TheLlamainator/TI84-AI-Mod/docs/index.md

---
layout: home
title: TI-84 AI Mod, WiFi and GPT for a calculator
titleTemplate: false
hero:
  text: "Give a <span class='ti'>TI-84</span> calculator WiFi"
  tagline: GPT chat, a camera view, a self-hosted server and wireless firmware updates, using an ESP32-S3.
  actions:
    - theme: brand
      text: Read the overview
      link: /overview
    - theme: alt
      text: Build it
      link: /ordering-the-pcb
    - theme: alt
      text: View on GitHub
      link: https://github.com/TheLlamainator/TI84-AI-Mod
features:
  - title: Ask GPT
    details: Type a question on the calculator, read the answer a page at a time, and reply to carry on the conversation.
  - title: Camera
    details: With a XIAO ESP32S3 Sense, take pictures and see a slow black-and-white live view on the calculator screen.
  - title: Wireless updates
    details: Update the calculator program and the ESP32 firmware over WiFi from the calculator's SETTINGS menu. No USB cable after the first flash.
  - title: Your own server
    details: A small Node.js server does the internet work. You run it, you hold the keys.
---
