TheLlamainator/TI84-AI-Mod/docs/credits.md

---
title: Credits and licence
---

# Credits and licence

This is a modification of the original **TI-32** project, released under the **GNU General Public License v3**. The original author has since taken the project down. The GPL grants everyone who received the code the right to keep, modify and share it, provided the licence and notices are kept. See [LICENSE](https://github.com/TheLlamainator/TI84-AI-Mod/blob/main/LICENSE) and [NOTICE.md](https://github.com/TheLlamainator/TI84-AI-Mod/blob/main/NOTICE.md) for what came from the original and what was changed here.

The calculator link code uses **ArTICL** by Kerm Martian (Cemetech), installed separately from its own repository.

This repository is licensed under the GPL v3 as well.

The calculator disassembly steps on the [Wiring and parts](/wiring) page are adapted from [TI-84 Plus Disassembly](https://www.ifixit.com/Guide/TI-84+Plus+Disassembly/117983) on iFixit by martijn muntenaar and 6 other contributors, licensed under [Creative Commons BY-NC-SA](https://creativecommons.org/licenses/by-nc-sa/3.0/). That section keeps that licence.
