TheLlamainator/TI84-AI-Mod/pcb/jlcpcb/BOM.csv

Comment | Designator | Footprint | LCSC Part #
MMBF170 | Q1,Q2 | SOT-23 | C130879
