TheLlamainator/TI84-AI-Mod/docs/wiring.md

# Wiring and hardware

> **TODO (author):** the wiring part of this page (below the disassembly) is still yours to write.

## 1. Open the calculator

::: info Source and licence
This section is adapted from **[TI-84 Plus Disassembly](https://www.ifixit.com/Guide/TI-84+Plus+Disassembly/117983)** on iFixit, by martijn muntenaar and 6 other contributors, licensed under [Creative Commons BY-NC-SA](https://creativecommons.org/licenses/by-nc-sa/3.0/). Changes: the text is lightly shortened, the photos are converted to PNG, and step 8 is added (it is not from iFixit). The licence on this section is **BY-NC-SA**, not the GPL used for the code. iFixit does not endorse this project.
:::

**Time:** about 10 minutes. **Difficulty:** moderate.

### What you need

- TR6 Torx security screwdriver
- Phillips #0 screwdriver
- Spudger
- Opening picks (a set of 6 works well)

### Step 1: Flip it over

Be sure the calculator is powered off before you start.

Take off the sliding cover, and flip your calculator to the back side.

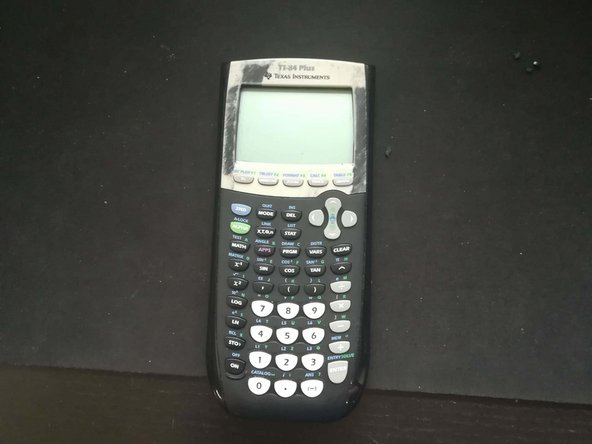
[picture p2: docs/public/img/disassembly/step-1-0.png]
Step 1: slide the cover off

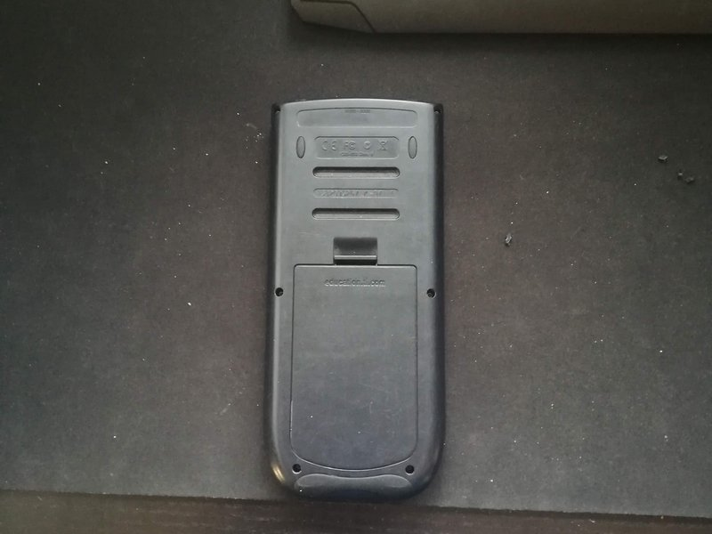
[picture p3: docs/public/img/disassembly/step-1-1.png]
Step 1: flip the calculator to the back


### Step 2: Remove the battery cover

Press down on the latch, then remove the battery cover.

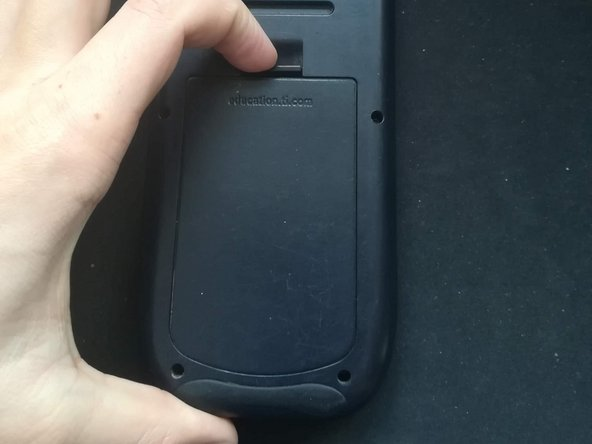
[picture p4: docs/public/img/disassembly/step-2-0.png]
Step 2: press the latch

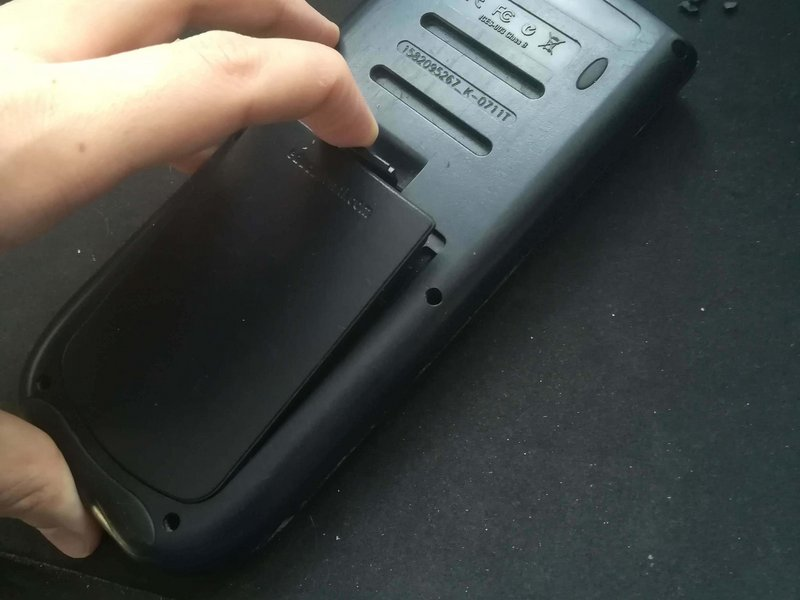
[picture p5: docs/public/img/disassembly/step-2-1.png]
Step 2: battery cover off


### Step 3: Take out the batteries

Remove the batteries. You can use the battery cover as a tray to keep them in.

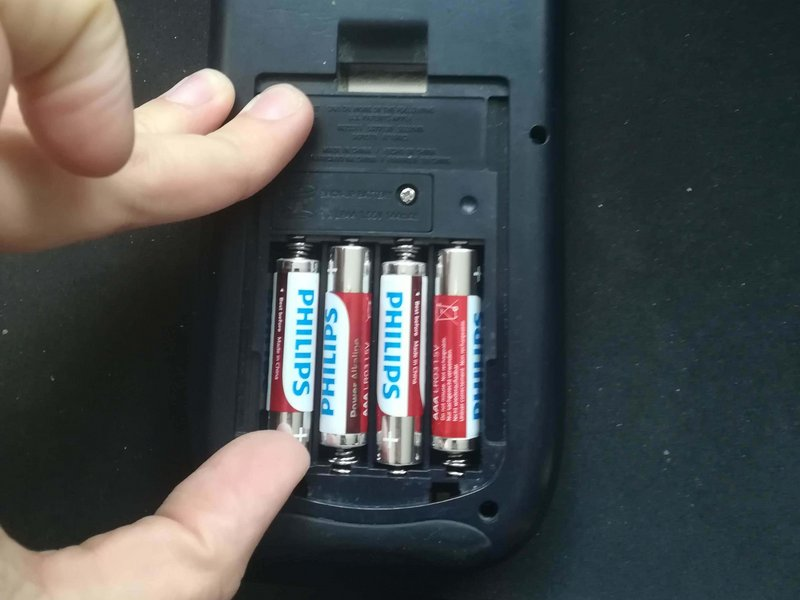
[picture p6: docs/public/img/disassembly/step-3-0.png]
Step 3: remove the batteries

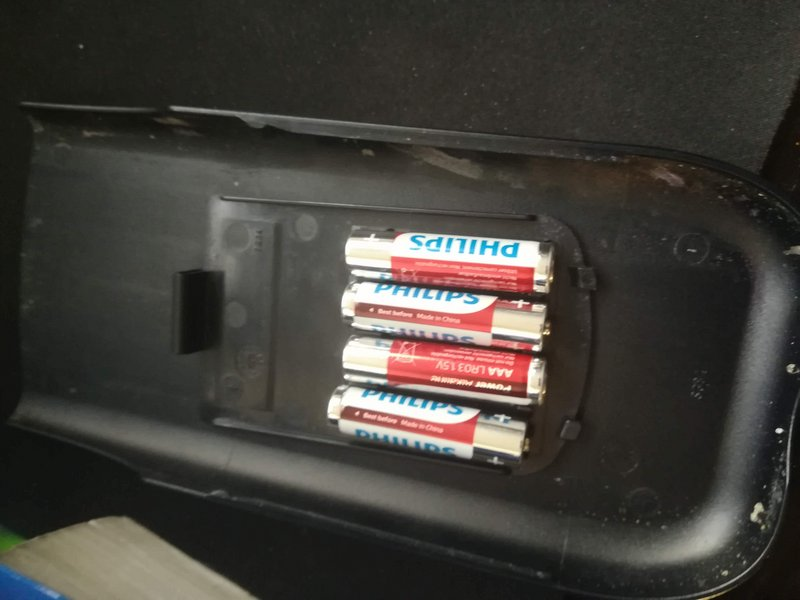
[picture p7: docs/public/img/disassembly/step-3-1.png]
Step 3: batteries out


### Step 4: Back-up battery plate

Removing the back-up battery will clear your RAM, so make a backup of anything important first.

Use a Phillips #0 to remove the plate over the back-up battery.

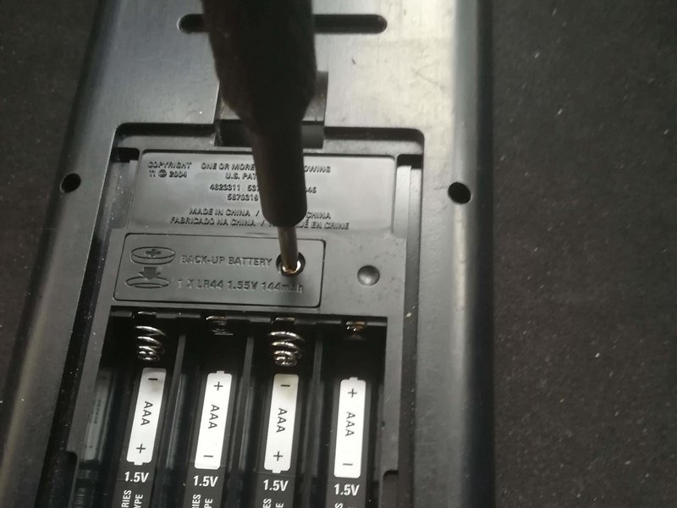
[picture p8: docs/public/img/disassembly/step-4-0.png]
Step 4: back-up battery plate

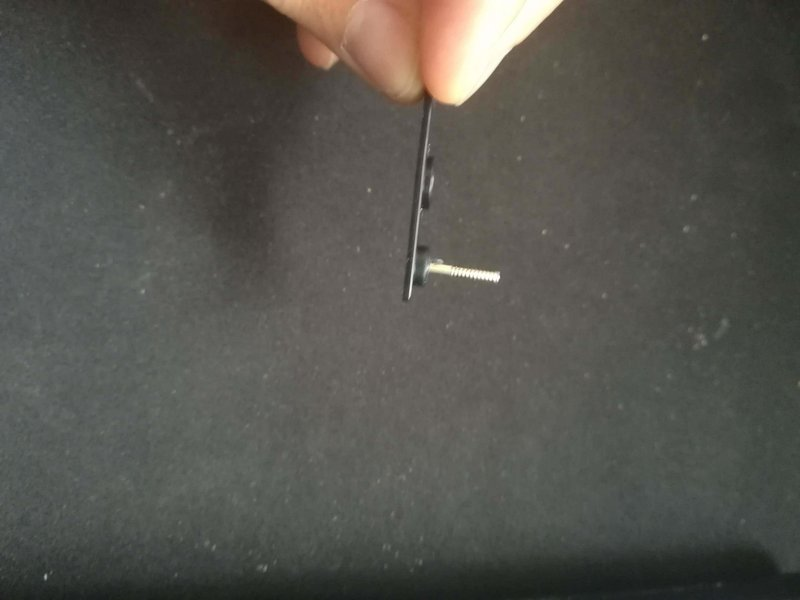
[picture p9: docs/public/img/disassembly/step-4-1.png]
Step 4: unscrew the plate

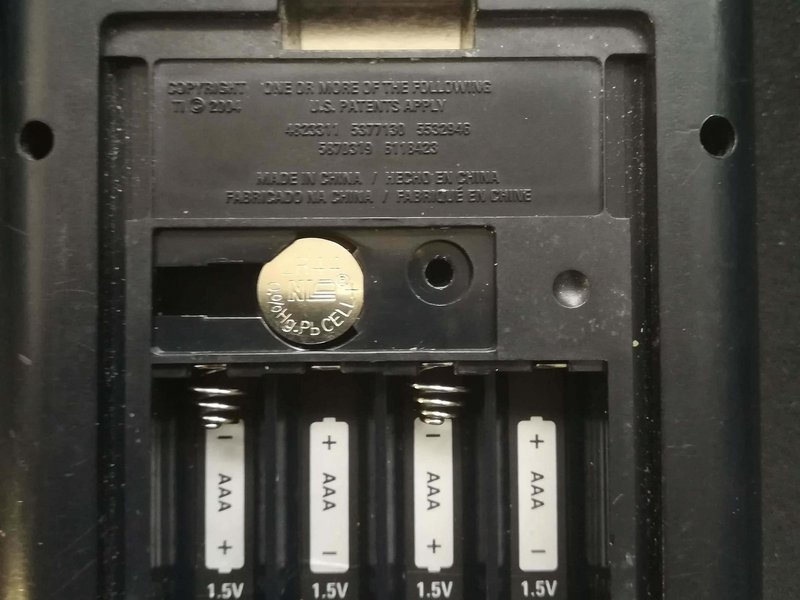
[picture p10: docs/public/img/disassembly/step-4-2.png]
Step 4: plate removed


### Step 5: Remove the back-up battery

Take out the back-up battery with a screwdriver or the spudger.

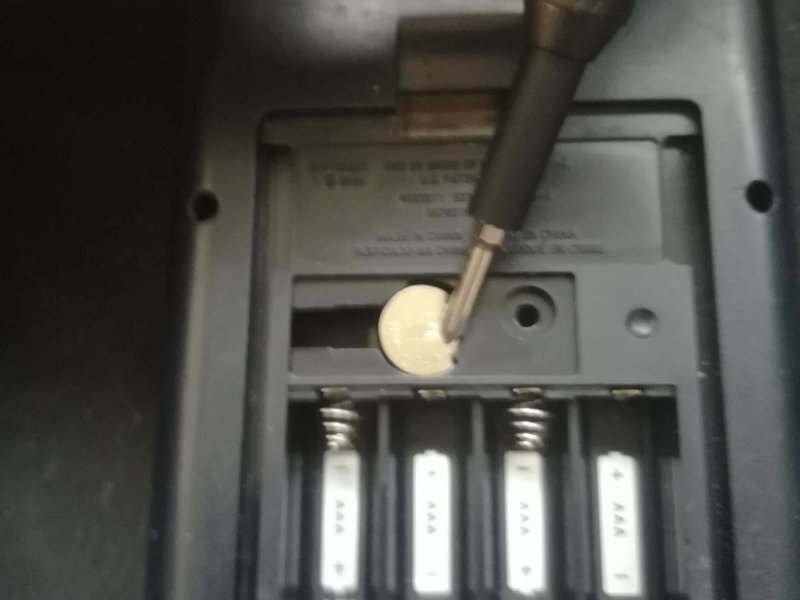
[picture p11: docs/public/img/disassembly/step-5-0.png]
Step 5: back-up battery in place

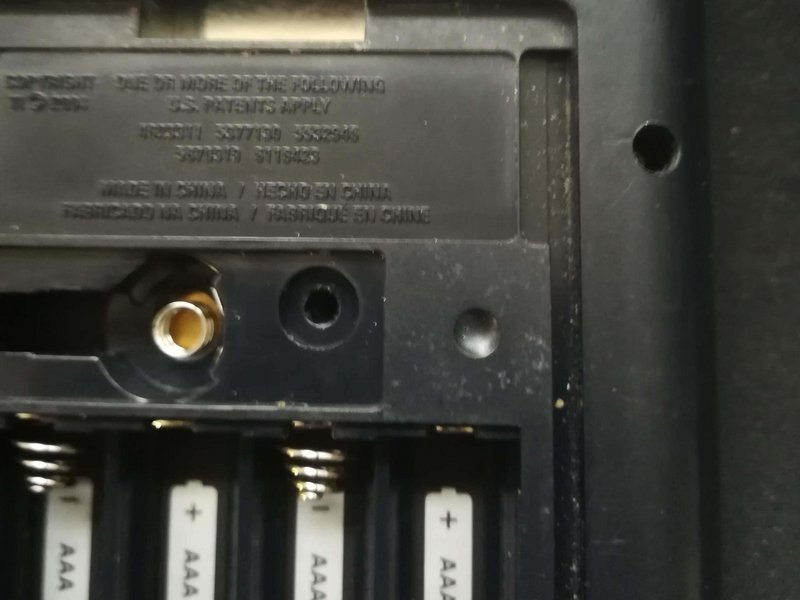
[picture p12: docs/public/img/disassembly/step-5-1.png]
Step 5: back-up battery removed


### Step 6: Remove the back cover screws

Use a T6 Torx screwdriver to remove the six screws holding the back cover on.

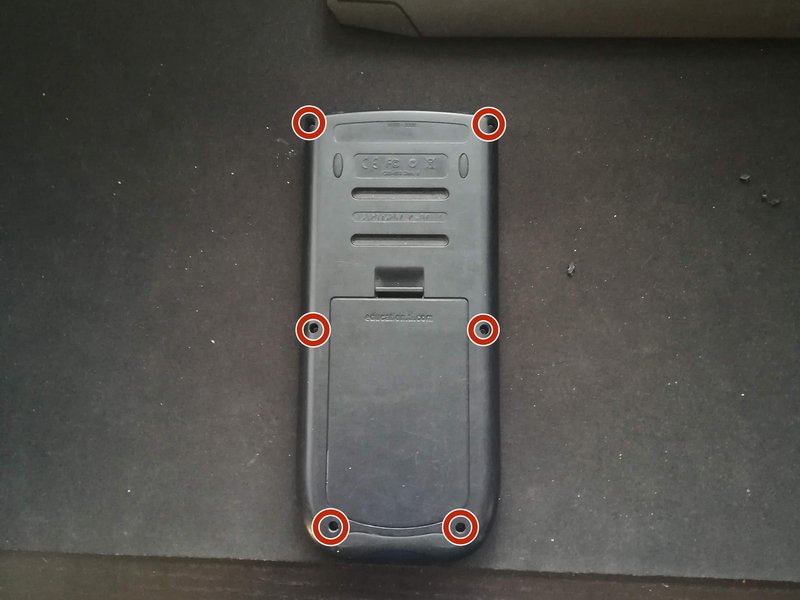
[picture p13: docs/public/img/disassembly/step-6.png]
Step 6: six Torx screws


::: tip Can't reach a screw?
If you can't get a screwdriver on one of the screws, what the author did was **melt the plastic around it with a soldering iron** until the screw came free. This leaves the case a little damaged, so only do it if you have to. Work in a ventilated room, keep the iron away from the circuit board inside, and let the plastic cool before you touch it.
:::

*This tip is from the author. It is not part of the iFixit guide.*

### Step 7: Open the case

Work a pick into the seam at the side, then slide it down the edge until the case opens.

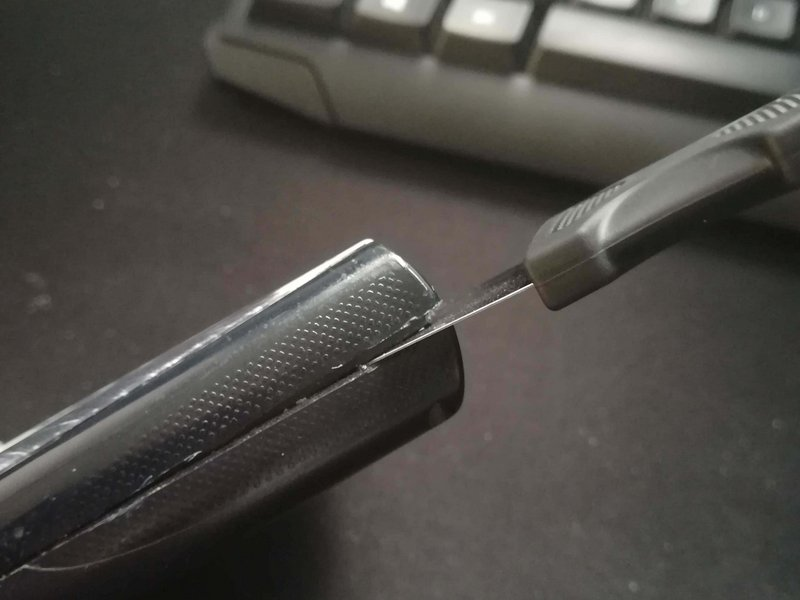
[picture p14: docs/public/img/disassembly/step-7-0.png]
Step 7: pick in the seam

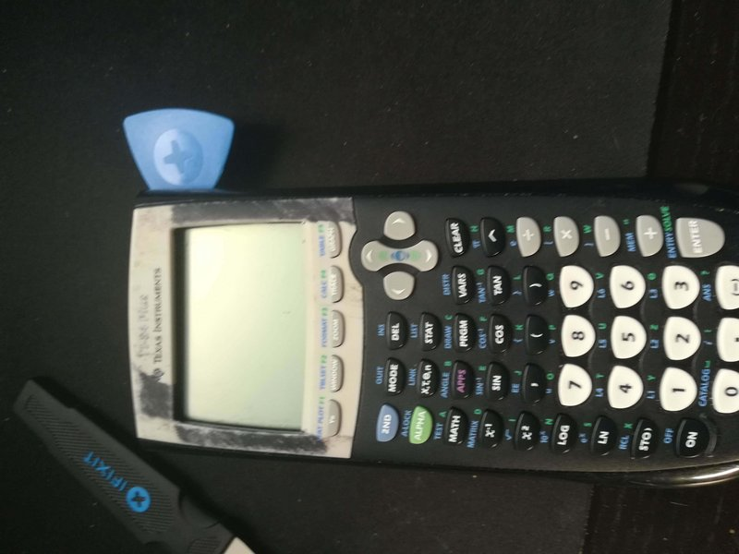
[picture p15: docs/public/img/disassembly/step-7-1.png]
Step 7: slide the pick down the side

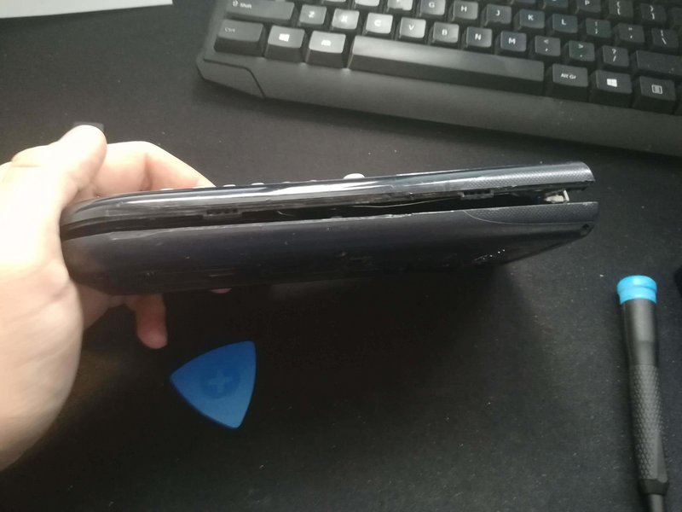
[picture p16: docs/public/img/disassembly/step-7-2.png]
Step 7: case open


### Step 8: Remove the metal sheet

Remove the metal sheet from inside the case.

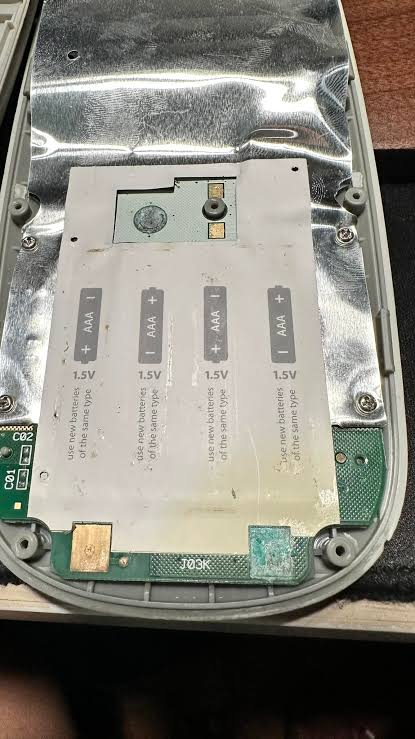
[picture p17: docs/public/img/disassembly/step-8.png]
Step 8: the metal foil sheet lining the inside of the case


> **TODO (author):** say how it comes out (clips, screws or just lifts out) and why it has to go.

*Steps 1 to 7 are adapted from iFixit. Step 8 is specific to this mod.*

To reassemble, follow the steps in reverse order.

## 2. Parts and wiring

From `pcb/cheating-calc.kicad_sch` (the files for ordering the board assembled are in `pcb/jlcpcb/`, see below):

- 1x Seeed Studio **XIAO ESP32S3 Sense** (camera version). The original schematic names a XIAO ESP32C3. The pin names are the same, but only the S3 Sense has a camera.
  - **The camera add-on is not required**, but it is recommended. Without it the chat, GPT and update features all work, and only the CAMERA menu doesn't.
- 2x **MMBF170** N-channel MOSFETs (SOT-23). One for the tip line, one for the ring line.
- 4x resistors (the schematic shows them only as `R`; fill in the values you used).
- 1x 4-pin header for the link cable: 5V, GND, TIP, RING.
- A link cable or plug for the calculator's link port. TI-83+/84+ calculators use a 2.5 mm stereo port: check yours before buying.

### Solder the XIAO onto the board

[JLCPCB](https://jlcpcb.com/?from=UNWIJQWZMTXVHID) places the two MOSFETs (see [ordering the PCB](/ordering-the-pcb)). You solder the rest: the four resistors, the 4-pin header and the XIAO module. The XIAO sits on the right of the board, with its USB-C port at the board's edge and its antenna lead clipped on.

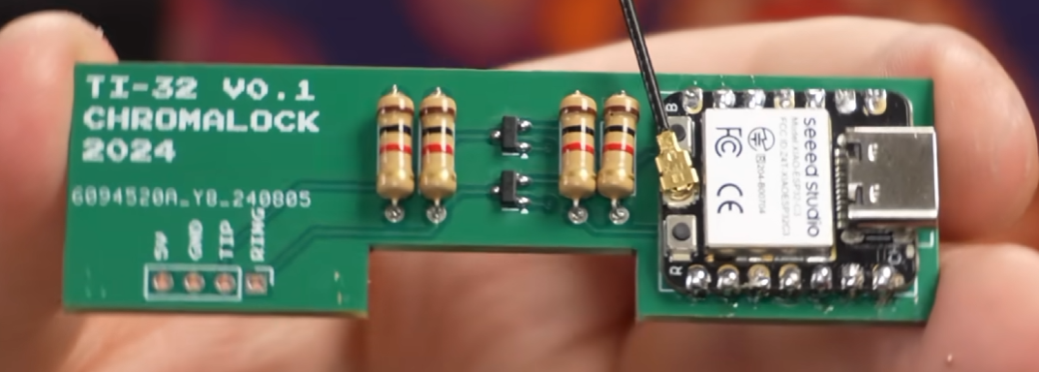
[picture p18: docs/public/img/soldering-esp32.png]
The XIAO ESP32S3 soldered onto the board, with the resistors and the 4-pin header


### Wire it to the calculator

On the left is the calculator's main board, on the right the back case with the mod board in place. Four wires run from the calculator board to the four pins of the header on the mod board.

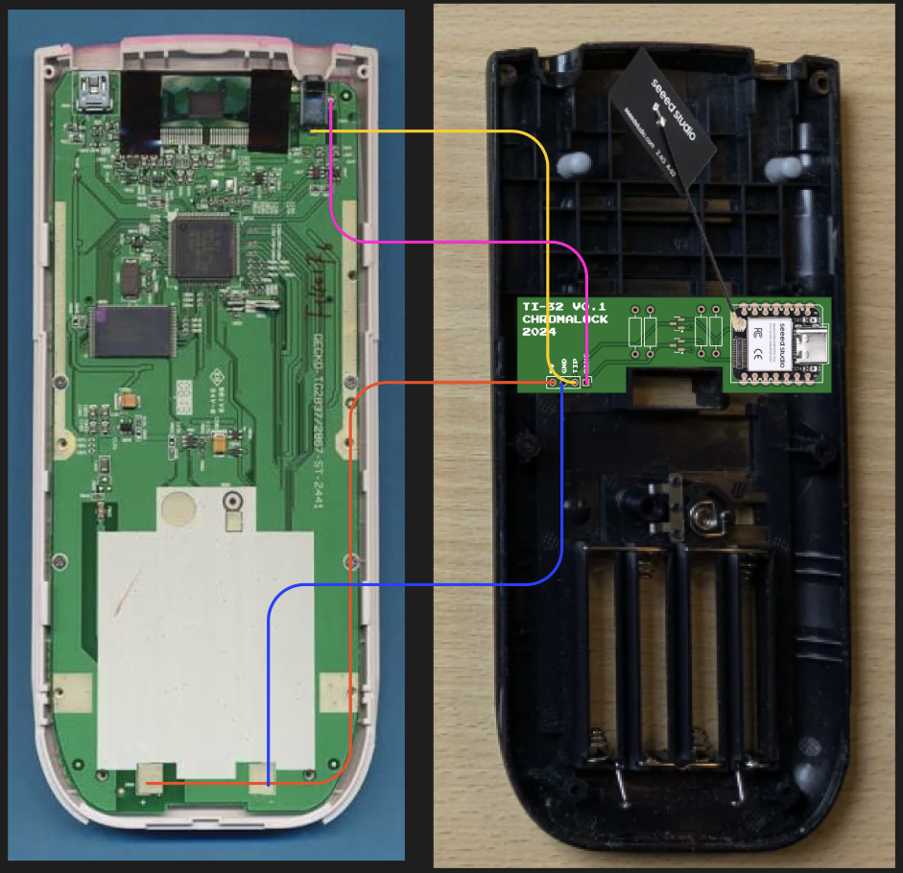
[picture p19: docs/public/img/wiring-diagram.png]
Wiring diagram: four wires from the calculator board to the mod board's 5V, GND, TIP and RING header


| Wire colour | Signal | Goes to on the calculator board |
| --- | --- | --- |
| Red | 5V | A pad at the bottom edge of the board |
| Blue | GND | A second pad at the bottom edge of the board |
| Yellow | TIP | The link port at the top of the board |
| Pink | RING | The link port at the top of the board |

## What the board does

The calculator's TIP and RING link lines work at up to about 5 V and are open-drain: either side pulls the line low to send. The ESP32's pins are 3.3 V. The board is a bidirectional level shifter for each line: one MOSFET plus a pull-up on each side.

The sketch uses `TIP = D1` and `RING = D10` (`esp32/esp32.ino`).

## Pictures

The built board

Schematic

PCB layout

## Files

- `pcb/cheating-calc.kicad_sch`, `.kicad_pcb`: KiCad design.
- `pcb/0.1/`: gerber and drill files, ready to send to a PCB maker.
- `pcb/jlcpcb/`: everything to upload when ordering the board assembled from [JLCPCB](https://jlcpcb.com/?from=UNWIJQWZMTXVHID). **Full ordering steps: [ordering the PCB](/ordering-the-pcb).** Upload `cheating-calc-gerbers.zip` as the gerber file, then `BOM.csv` and `CPL.csv` at the assembly step. They cover only the two SMD parts (Q1 and Q2, the MMBF170 MOSFETs, LCSC C130879). The resistors, header and XIAO module are soldered by hand. Positions are measured from the board's lower-left corner.
- `pcb/cpl-all-parts.csv`: the placement of every part, for reference or hand assembly.
- `pcb/schematic.png`, `pcb/pcb.png`, `pcb/built.png`: pictures.

## 3. The finished mod

The finished mod: the calculator's main board on the left, and the back case with the mod board on the right

### How it is mounted

The mod board sits in the back case, above the battery compartment, with its USB-C port at the edge and the antenna lead running along the case. It is not screwed down. The wires from the calculator board to the mod board's header are held in place with tape, and so are the two bottom pads they are soldered to. Close the case once everything is wired and tested.

### Pinout

The four pins of the header on the mod board, as printed on the board (left to right):

| Pin | Signal | What it is |
| --- | --- | --- |
| 1 | 5V | Power from the calculator |
| 2 | GND | Ground |
| 3 | TIP | Link port data line |
| 4 | RING | Link port data line |

### Cable colours

Use the colours in the [wiring diagram table](#wire-it-to-the-calculator): red for 5V, blue for GND, yellow for TIP and pink for RING.

The wires in the photo above are red, black, blue and orange, so they don't match the table. Colour doesn't matter electrically. What matters is that each wire goes to the right pin on the header and the right place on the calculator board.
