TheLlamainator/TI84-AI-Mod/source/test-images/image.png

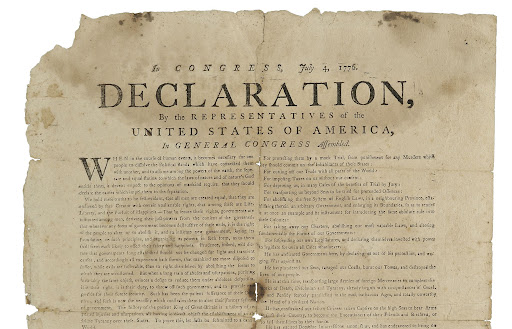
source/test-images/image.png
