TheLlamainator/TI84-AI-Mod/esp32/launcher.h

unsigned char __launcher_var[] = {
  0x43, 0x09, 0x3e, 0x44, 0x43, 0x53, 0x3f, 0x2a, 0x42, 0x42, 0x39, 0x39,
  0x39, 0x39, 0x39, 0x39, 0x39, 0x39, 0x39, 0x39, 0x39, 0x39, 0x42, 0x42,
  0x42, 0x39, 0x39, 0x39, 0x39, 0x39, 0x39, 0x39, 0x39, 0x39, 0x39, 0x39,
  0x39, 0x39, 0x39, 0x42, 0x39, 0x39, 0x39, 0x39, 0x39, 0x39, 0x42, 0x42,
  0x42, 0x39, 0x39, 0x39, 0x39, 0x39, 0x39, 0x39, 0x39, 0x39, 0x39, 0x39,
  0x39, 0x42, 0x39, 0x39, 0x42, 0x42, 0x42, 0x42, 0x39, 0x39, 0x39, 0x39,
  0x39, 0x39, 0x39, 0x42, 0x42, 0x39, 0x39, 0x42, 0x39, 0x39, 0x39, 0x39,
  0x42, 0x39, 0x39, 0x39, 0x39, 0x39, 0x42, 0x39, 0x42, 0x39, 0x42, 0x39,
  0x39, 0x42, 0x42, 0x39, 0x42, 0x39, 0x39, 0x39, 0x39, 0x39, 0x42, 0x39,
  0x42, 0x39, 0x42, 0x42, 0x42, 0x39, 0x39, 0x42, 0x42, 0x39, 0x39, 0x39,
  0x39, 0x39, 0x42, 0x39, 0x42, 0x39, 0x42, 0x39, 0x39, 0x42, 0x42, 0x39,
  0x39, 0x42, 0x39, 0x39, 0x39, 0x39, 0x42, 0x39, 0x39, 0x42, 0x42, 0x39,
  0x39, 0x42, 0x39, 0x42, 0x39, 0x42, 0x39, 0x39, 0x39, 0x39, 0x39, 0x42,
  0x42, 0x39, 0x39, 0x42, 0x42, 0x42, 0x39, 0x42, 0x39, 0x42, 0x39, 0x39,
  0x39, 0x39, 0x39, 0x42, 0x39, 0x42, 0x42, 0x39, 0x39, 0x42, 0x39, 0x42,
  0x39, 0x42, 0x39, 0x39, 0x39, 0x39, 0x39, 0x42, 0x39, 0x39, 0x39, 0x39,
  0x42, 0x39, 0x39, 0x42, 0x42, 0x39, 0x39, 0x39, 0x39, 0x39, 0x39, 0x39,
  0x42, 0x42, 0x42, 0x42, 0x39, 0x39, 0x42, 0x39, 0x39, 0x39, 0x39, 0x39,
  0x39, 0x39, 0x39, 0x39, 0x39, 0x39, 0x39, 0x42, 0x42, 0x42, 0x39, 0x39,
  0x39, 0x39, 0x39, 0x39, 0x42, 0x39, 0x39, 0x39, 0x39, 0x39, 0x39, 0x39,
  0x39, 0x39, 0x39, 0x39, 0x39, 0x39, 0x39, 0x42, 0x42, 0x42, 0x39, 0x39,
  0x39, 0x39, 0x39, 0x39, 0x39, 0x39, 0x39, 0x39, 0x39, 0x39, 0x42, 0x42,
  0x2a, 0x3f, 0x3f, 0xe1, 0x3f, 0x85, 0x3f, 0x34, 0x32, 0x30, 0x36, 0x39,
  0x04, 0x50, 0x3f, 0xe7, 0x50, 0x11, 0x3f, 0x3f, 0xd6, 0x51, 0x31, 0x3e,
  0x3f, 0xe1, 0x3f, 0x85, 0x3f, 0x30, 0x04, 0x53, 0x3f, 0x30, 0x04, 0x45,
  0x3f, 0x2a, 0x2a, 0x04, 0xaa, 0x09, 0x3f, 0xe6, 0x2a, 0x4f, 0x50, 0x45,
  0x52, 0x41, 0x54, 0x49, 0x4f, 0x4e, 0x2a, 0x2b, 0x2a, 0x53, 0x45, 0x54,
  0x54, 0x49, 0x4e, 0x47, 0x53, 0x2a, 0x2b, 0x4b, 0x30, 0x2b, 0x2a, 0x49,
  0x4d, 0x41, 0x47, 0x45, 0x53, 0x2a, 0x2b, 0x49, 0x30, 0x2b, 0x2a, 0x41,
  0x50, 0x50, 0x53, 0x2a, 0x2b, 0x53, 0x30, 0x2b, 0x2a, 0x43, 0x48, 0x41,
  0x54, 0x2a, 0x2b, 0x54, 0x30, 0x2b, 0x2a, 0x41, 0x53, 0x4b, 0x29, 0x47,
  0x50, 0x54, 0x2a, 0x2b, 0x47, 0x30, 0x2b, 0x2a, 0x47, 0x50, 0x54, 0x29,
  0x48, 0x49, 0x53, 0x54, 0x4f, 0x52, 0x59, 0x2a, 0x2b, 0x47, 0x31, 0x2b,
  0x2a, 0x43, 0x41, 0x4d, 0x45, 0x52, 0x41, 0x2a, 0x2b, 0x43, 0x39, 0x11,
  0x3f, 0x3f, 0xd6, 0x43, 0x39, 0x3f, 0xe1, 0x3f, 0x37, 0x04, 0x43, 0x3f,
  0x30, 0x04, 0x53, 0x3f, 0xe7, 0x43, 0x11, 0x3f, 0xd2, 0x53, 0x3f, 0xe8,
  0x53, 0x11, 0x3f, 0xd4, 0x3f, 0xe8, 0xaa, 0x00, 0x11, 0x3f, 0x30, 0x04,
  0x4b, 0x3f, 0xd2, 0x4b, 0x6a, 0x34, 0x35, 0x3f, 0xe8, 0x60, 0x00, 0x11,
  0x3f, 0x99, 0x60, 0x00, 0x3f, 0xad, 0x04, 0x4b, 0x3f, 0xd4, 0x3f, 0xd7,
  0x51, 0x31, 0x3f, 0x3f, 0x3f, 0xd6, 0x46, 0x30, 0x3f, 0xe1, 0x3f, 0xde,
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
};
unsigned int __launcher_var_len = 2373;
