TheLlamainator/TI84-AI-Mod/(commit log)

2026-10-26 Initial commit: TI-84 WiFi/GPT/camera mod based on TI-32 (GPL v3)
2026-10-26 Docs: disassembly guide, wiring diagram, favicon, rename to TI84-AI-Mod
2026-10-26 Docs: downloads page, finished mod, wiring diagram, first transfer, referral links
