TheLlamainator/TI84-AI-Mod/(notices)

Notices in the files:
README.md:
License: GPL v3
